formatc1702/kTrainer/Media/Photos/Assembly/2017-06-02 23.36.27.jpg

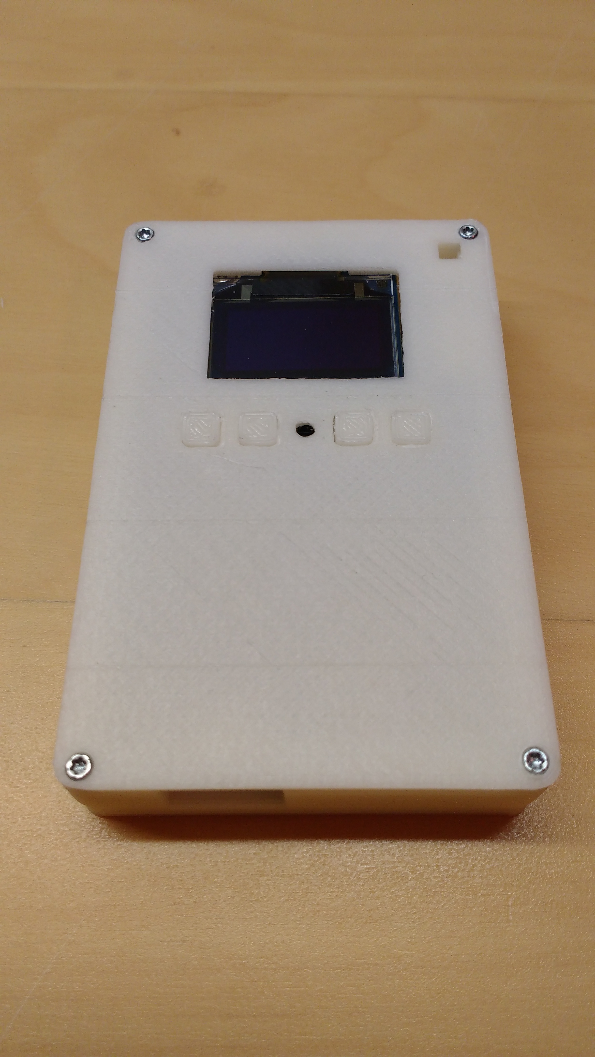
Media/Photos/Assembly/2017-06-02 23.36.27.jpg
