formatc1702/kTrainer/EAGLE/ktrainer.dxf

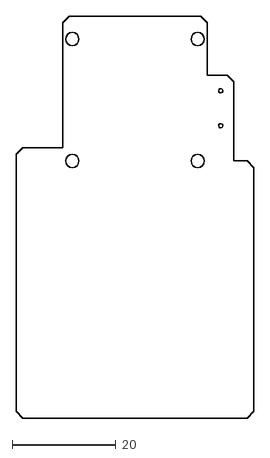
[picture p3: CAD file, 2017-05-26]
EAGLE/ktrainer.dxf
45.7 x 77.5
