formatc1702/kTrainer/Mechanical/parts-3d-print/STL/case-bottom.stl

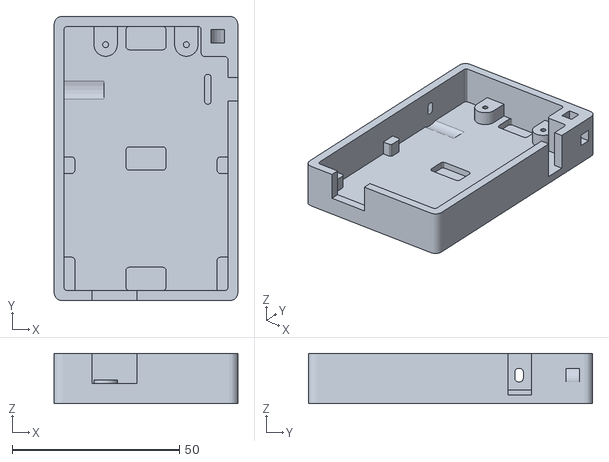
[picture p4: CAD file, 2017-06-03]
Mechanical/parts-3d-print/STL/case-bottom.stl
55.0 x 85.0 x 15.0
