formatc1702/kTrainer/Mechanical/Test/buttontest.stl

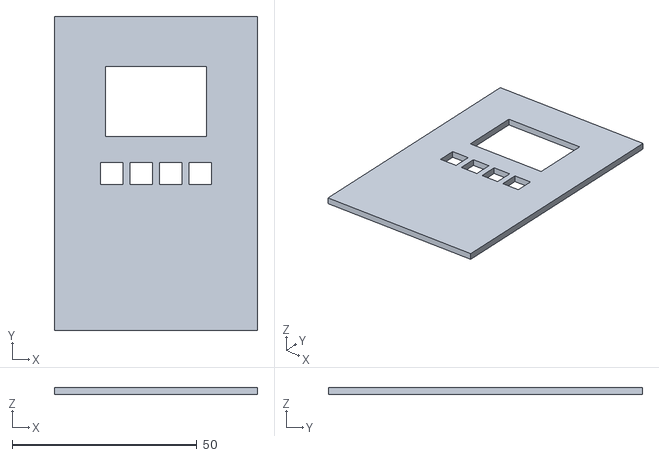
[picture p5: CAD file, 2017-03-10]
Mechanical/Test/buttontest.stl
55.0 x 85.0 x 2.00
