formatc1702/kTrainer/Mechanical/parts-3d-print/STL/button-double.stl

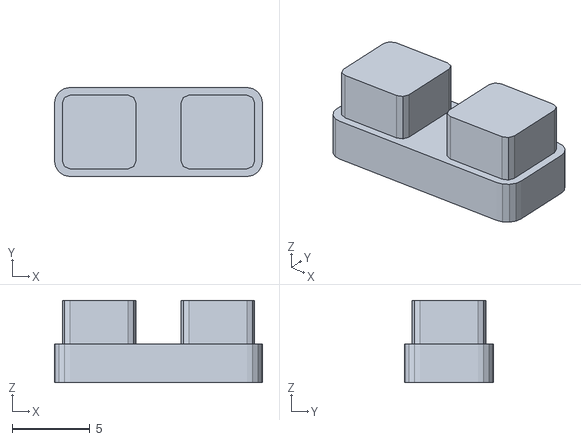
[picture p6: CAD file, 2017-06-03]
Mechanical/parts-3d-print/STL/button-double.stl
13.4 x 5.74 x 5.30
