formatc1702/kTrainer/Mechanical/parts-3d-print/STL/case-top.stl

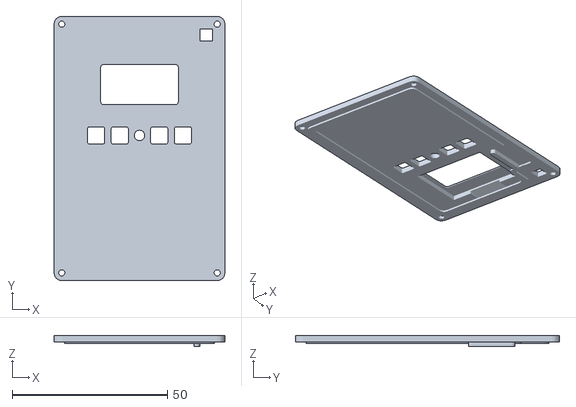
[picture p7: CAD file, 2017-06-02]
Mechanical/parts-3d-print/STL/case-top.stl
55.0 x 85.0 x 3.50
