formatc1702/kTrainer/Mechanical/parts-3d-print/STL/oled-spacer.stl

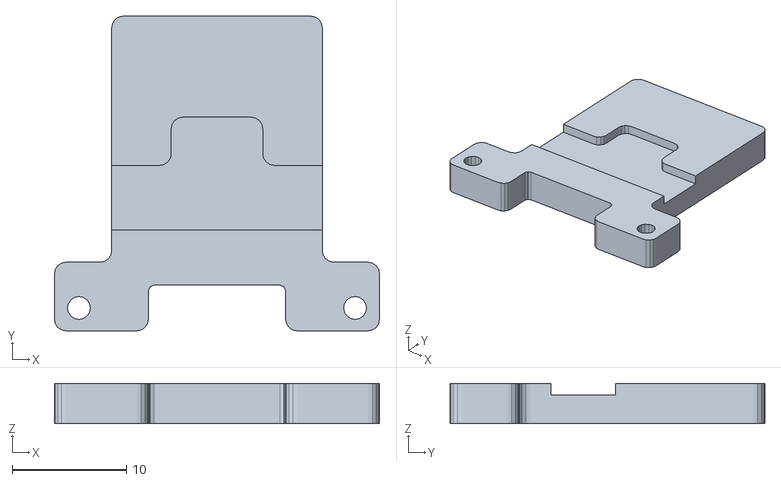
[picture p8: CAD file, 2017-06-02]
Mechanical/parts-3d-print/STL/oled-spacer.stl
28.4 x 27.5 x 3.50
