formatc1702/kTrainer/Mechanical/parts-3d-print/STL/slider.stl

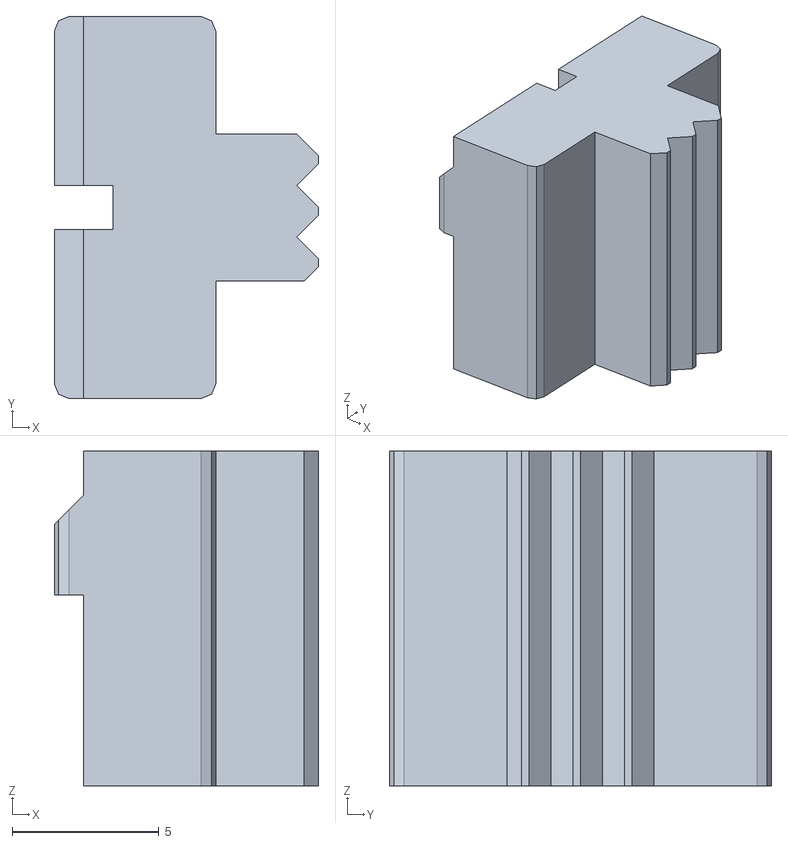
[picture p9: CAD file, 2017-06-02]
Mechanical/parts-3d-print/STL/slider.stl
9.00 x 13.0 x 11.4
