formatc1702/kTrainer/Media/Photos/Assembly/2017-06-02 22.41.26.jpg

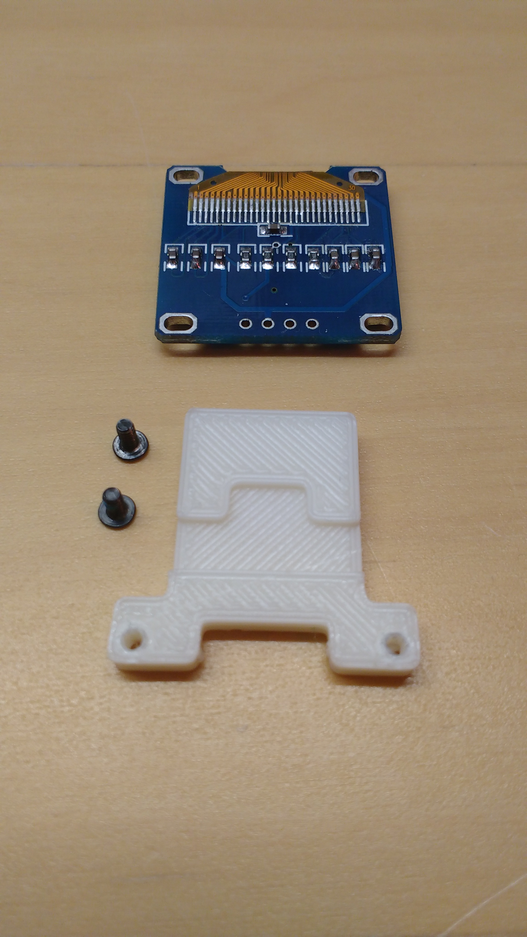
Media/Photos/Assembly/2017-06-02 22.41.26.jpg
