formatc1702/kTrainer/Media/Photos/Assembly/2017-06-02 22.42.33.jpg

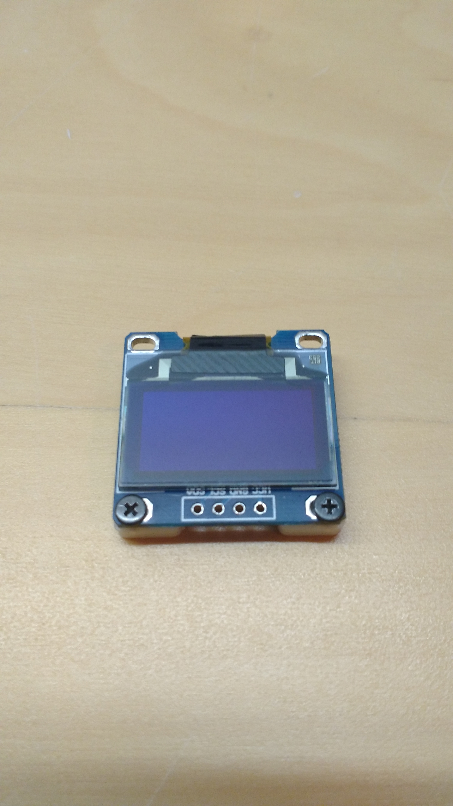
Media/Photos/Assembly/2017-06-02 22.42.33.jpg
