formatc1702/kTrainer/Media/Photos/Assembly/2017-06-02 23.09.38.jpg

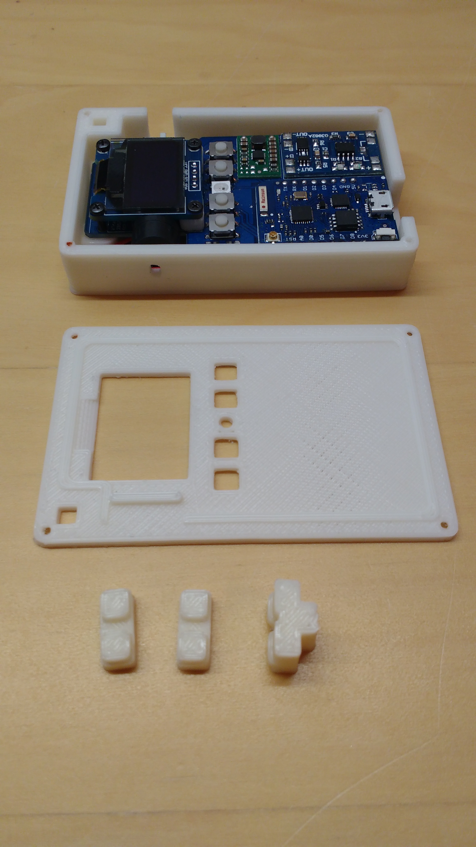
Media/Photos/Assembly/2017-06-02 23.09.38.jpg
