formatc1702/kTrainer/Media/Photos/Assembly/2017-06-02 23.37.00.jpg

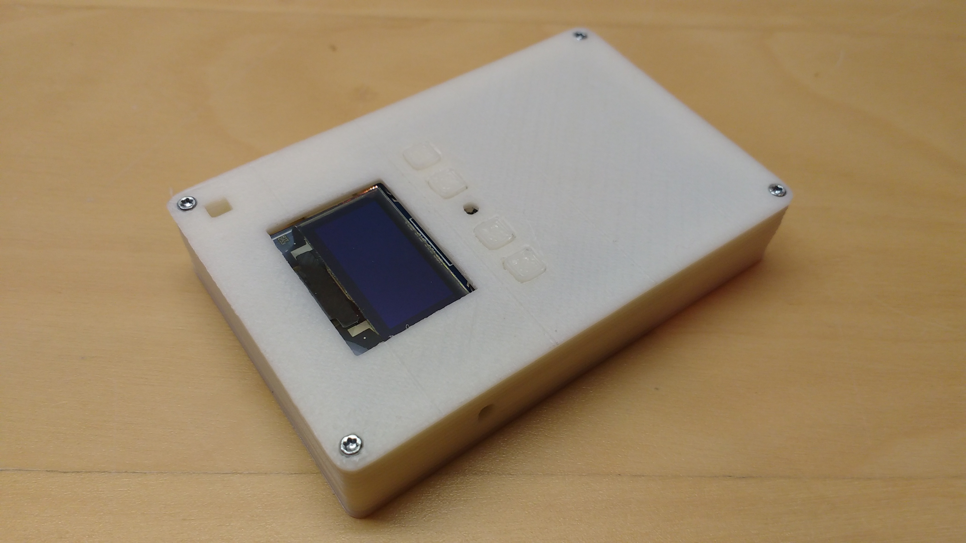
Media/Photos/Assembly/2017-06-02 23.37.00.jpg
