formatc1702/kTrainer/Media/Photos/Assembly/2017-06-02 23.48.02.jpg

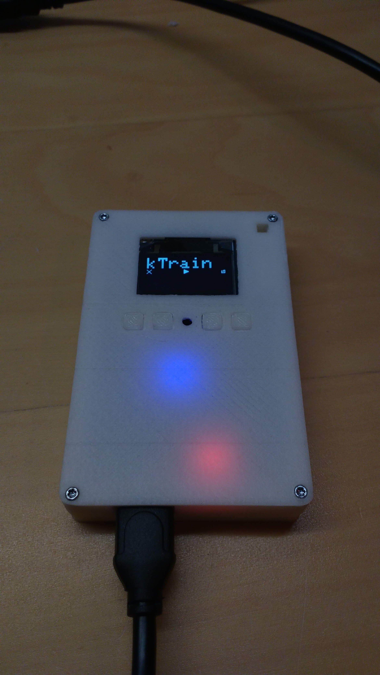
Media/Photos/Assembly/2017-06-02 23.48.02.jpg
