formatc1702/kTrainer/Media/Photos/Assembly/2017-06-03 13.04.07.jpg

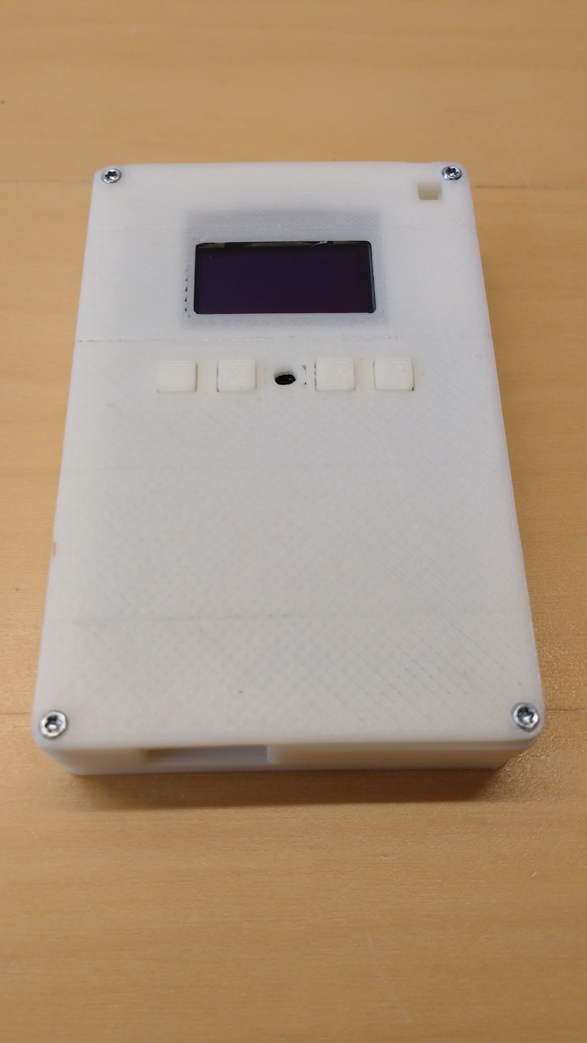
Media/Photos/Assembly/2017-06-03 13.04.07.jpg
