formatc1702/kTrainer/EAGLE/ktrainer.brd

## EAGLE design EAGLE/ktrainer.brd (2018-06-24)

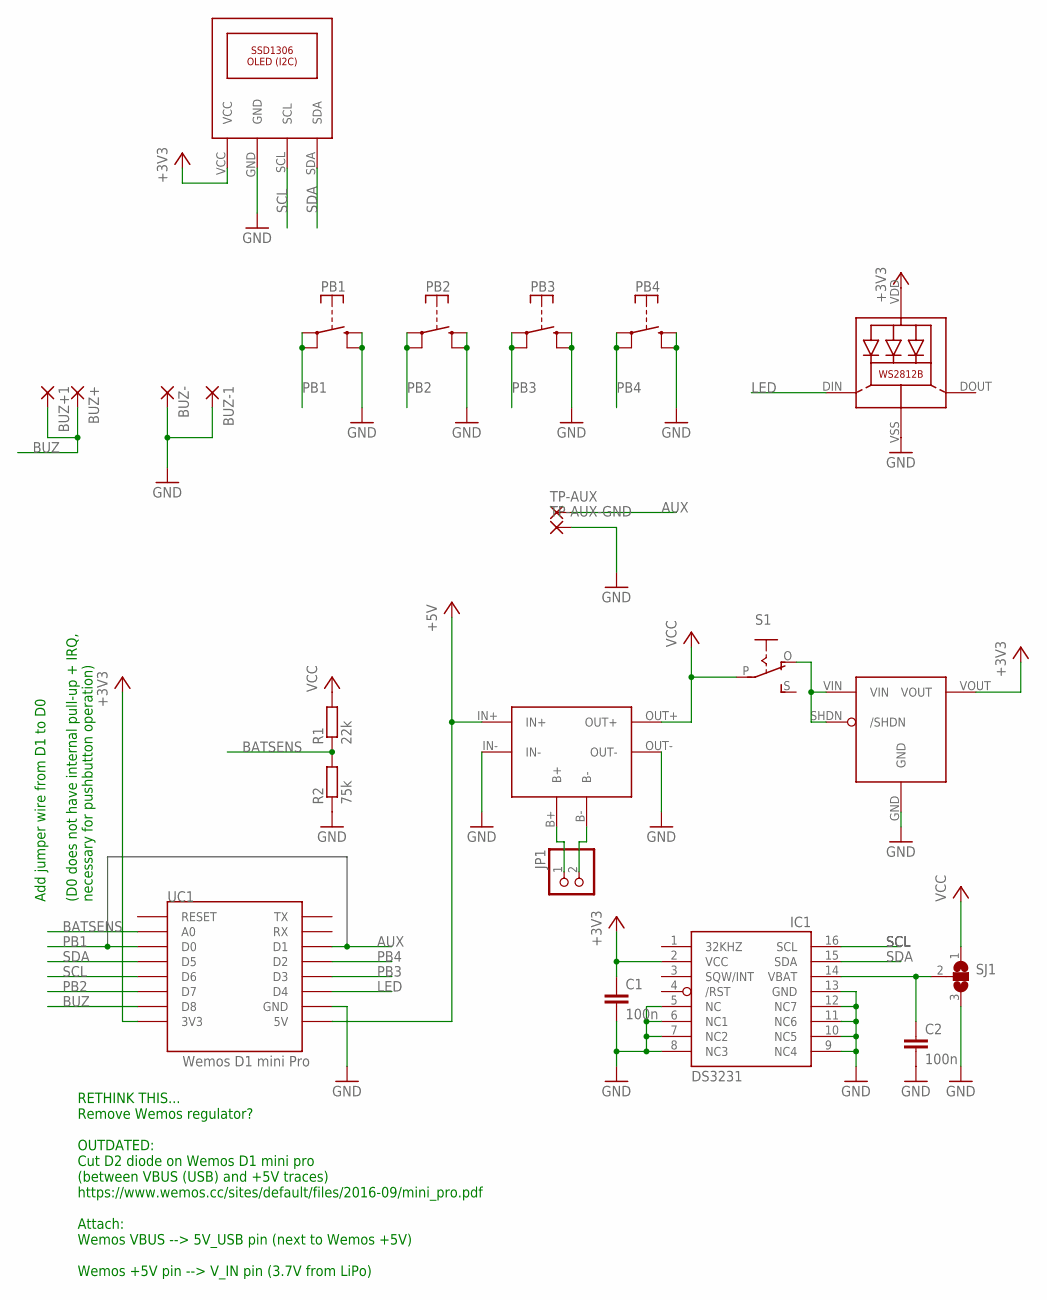
[picture p28: schematic ktrainer.sch]

Parts:
BUZ+, BUZ+1: SMD2; SMD1,27-2,54
BUZ-, BUZ-1: SMD2; SMD1,27-2,54
C1, C2: 100n; C0805
IC1: DS3231/SO; SO16W
JP1: PINHD-1X2; 1X02
LED1: WS2812B
PB1, PB2, PB3, PB4: SWITCH-SKRA; SWITCH-SKRA-PKG
R1: 22k; R0805
R2: 75k; R0805
S1: SWITCH-MSK12D04-SLIDER-SMD; SWITCH-MSK12D04-SLIDER-SMD-PKG
SJ1: SJ2W; SJ_2
TP-AUX: SMD2; SMD1,27-2,54
TP-AUX-GND: SMD2; SMD1,27-2,54
U$1: TP4056-LIPO-CHG-PCBTP4056-PCB-SMD; TP4056-PCB-SMD
U$2: SSD1306-OLED-128X64-I2CSSD1306-OLED-128X64-SMD; SSD1306-OLED-128X64-SMD
U$3: POLOLU-S7V8F3-3V3-STEP-UP-DOWNPOLOLU-S7V8F3-PAD; POLOLU-S7V8F3-SMD
UC1: Wemos D1 mini Pro; WEMOS-D1-MINI-SMD

Connections:
+3V3: C1.1, IC1.2 (VCC), LED1.VDD, U$2.VCC, U$3.VOUT, UC1.3V3
+5V: U$1.IN+, UC1.5V
AUX: TP-AUX.1, UC1.D1
B-: JP1.2, U$1.B-
BATSENS: R1.1, R2.2, UC1.A0
BUZ: BUZ+.1, BUZ+1.1, UC1.D8
GND: BUZ-.1, BUZ-1.1, C1.2, C2.2, IC1.5 (NC), IC1.6 (NC1), IC1.7 (NC2), IC1.8 (NC3), IC1.9 (NC4), IC1.10 (NC5), IC1.11 (NC6), IC1.12 (NC7), IC1.13 (GND), LED1.VSS (GND), PB1.P$1, PB1.P$2, PB2.P$1, PB2.P$2, PB3.P$1, PB3.P$2, PB4.P$1, PB4.P$2, R2.1, SJ1.3, TP-AUX-GND.1, U$1.IN-, U$1.OUT-, U$2.GND, U$3.GND, UC1.GND
LED: LED1.DIN (DI), UC1.D4
unnamed: S1.O, U$3.SHDN (/SHDN), U$3.VIN
PB1: PB1.P$3 (S), PB1.P$4 (S), UC1.D0
PB2: PB2.P$3 (S), PB2.P$4 (S), UC1.D7
PB3: PB3.P$3 (S), PB3.P$4 (S), UC1.D3
PB4: PB4.P$3 (S), PB4.P$4 (S), UC1.D2
SCL: IC1.16 (SCL), U$2.SCL, UC1.D6
SDA: IC1.15 (SDA), U$2.SDA, UC1.D5
VBAT: C2.1, IC1.14 (VBAT), SJ1.2
VCC: JP1.1, R1.2, S1.P, SJ1.1, U$1.B+, U$1.OUT+

Notes on the sheet:
RETHINK THIS... Remove Wemos regulator? OUTDATED: Cut D2 diode on Wemos D1 mini pro (between VBUS (USB) and +5V traces) https://www.wemos.cc/sites/default/files/2016-09/mini_pro.pdf Attach: Wemos VBUS --> 5V_USB pin (next to Wemos +5V) Wemos +5V pin --> V_IN pin (3.7V from LiPo)
Add jumper wire from D1 to D0 (D0 does not have internal pull-up + IRQ, necessary for pushbutton operation)

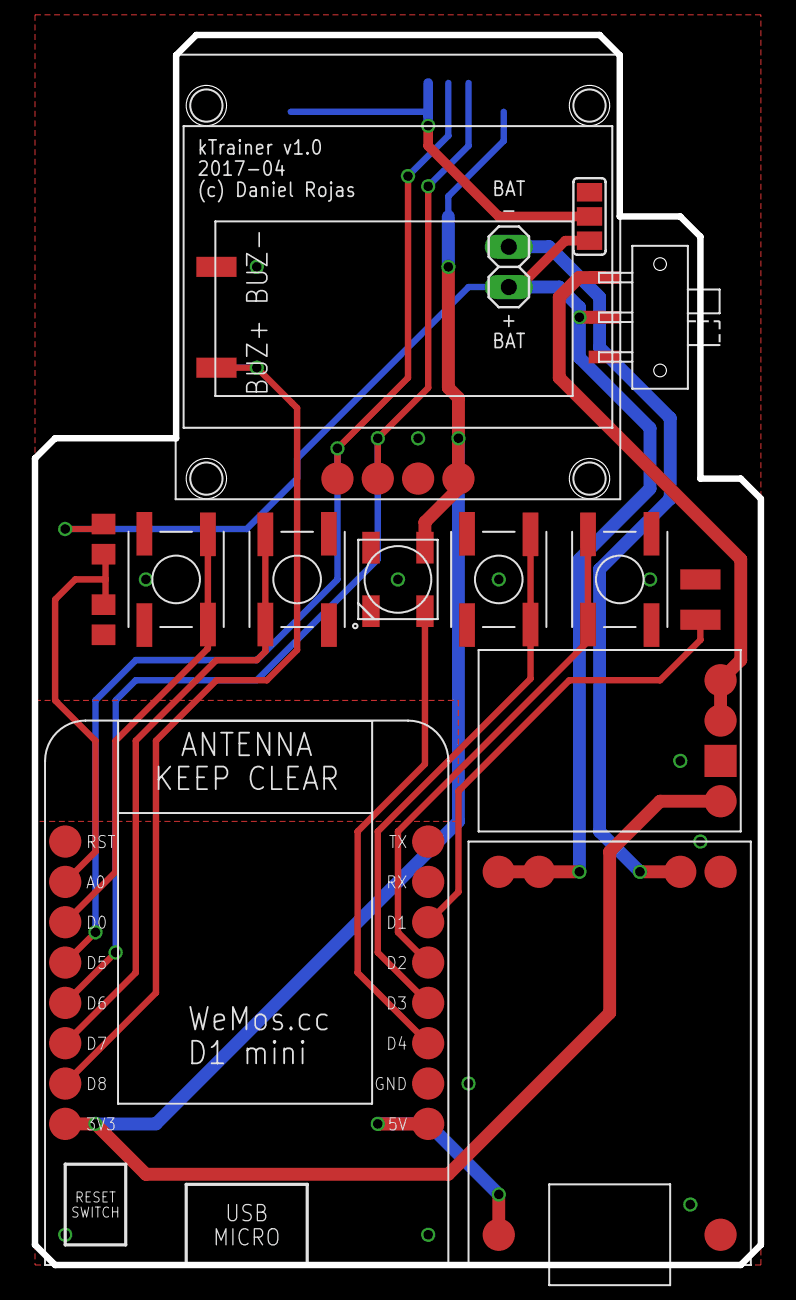
[picture p29: board ktrainer.brd from above]

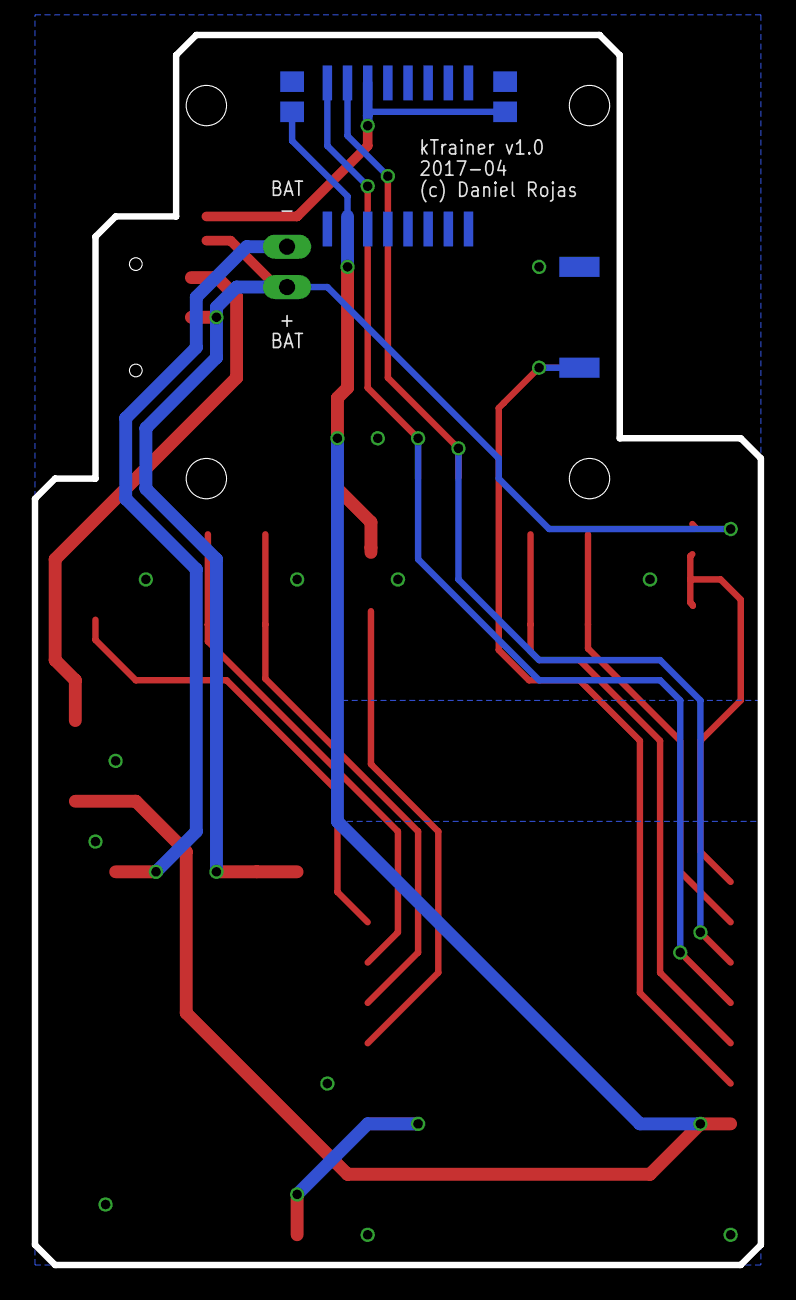
[picture p30: board ktrainer.brd from below]

Board: 2 copper layers, 45.7 x 77.5 mm, 23 parts (5 on the bottom side), 17 nets.
