formatc1702/kTrainer/Firmware/bitmapfont.py

# MicroPython basic bitmap font renderer.
# Author: Tony DiCola
# License: MIT License (https://opensource.org/licenses/MIT)
import ustruct


class BitmapFont:

    def __init__(self, width, height, pixel, fill_rect, font_name='font5x8.bin'):
        # Specify the drawing area width and height, and the pixel function to
        # call when drawing pixels (should take an x and y param at least).
        # Optionally specify font_name to override the font file to use (default
        # is font5x8.bin).  The font format is a binary file with the following
        # format:
        # - 1 unsigned byte: font character width in pixels
        # - 1 unsigned byte: font character height in pixels
        # - x bytes: font data, in ASCII order covering all 255 characters.
        #            Each character should have a byte for each pixel column of
        #            data (i.e. a 5x8 font has 5 bytes per character).
        self._width = width
        self._height = height
        self._pixel = pixel
        self._fill_rect = fill_rect
        self._font_name = font_name

    def init(self):
        # Open the font file and grab the character width and height values.
        # Note that only fonts up to 8 pixels tall are currently supported.
        self._font = open(self._font_name, 'rb')
        self._font_width, self._font_height = ustruct.unpack('BB', self._font.read(2))

    def deinit(self):
        # Close the font file as cleanup.
        self._font.close()

    def __enter__(self):
        self.init()
        return self

    def __exit__(self, exception_type, exception_value, traceback):
        self.deinit()

    def draw_char(self, ch, x, y, size, *args, **kwargs):
        # Don't draw the character if it will be clipped off the visible area.
        if x < -self._font_width or x >= self._width or \
           y < -self._font_height or y >= self._height:
            return
        # Go through each column of the character.
        for char_x in range(self._font_width):
            # Grab the byte for the current column of font data.
            self._font.seek(2 + (ord(ch) * self._font_width) + char_x)
            line = ustruct.unpack('B', self._font.read(1))[0]
            # Go through each row in the column byte.
            if size == 1:
                for char_y in range(self._font_height):
                    # Draw a pixel for each bit that's flipped on.
                    if (line >> char_y) & 0x1:
                        self._pixel(x + char_x, y + char_y, *args, **kwargs)
            else:
                for char_y in range(self._font_height):
                    # Draw a pixel for each bit that's flipped on.
                    if (line >> char_y) & 0x1:
                        self._fill_rect(x + (char_x * size), y + (char_y * size), size, size, *args, **kwargs)
                        # for rr in range(0,size):
                            # for cc in range(0,size):
                                # self._pixel(x + (char_x) * size + cc,y +  (char_y) * size + rr, *args, **kwargs)

    def text(self, text, x, y, size=1, *args, **kwargs):
        # Draw the specified text at the specified location.
        for i in range(len(text)):
            self.draw_char(text[i], x + (i * (self._font_width + 1) * size), y, size,
                           *args, **kwargs)

    def width(self, text):
        # Return the pixel width of the specified text message.
        return len(text) * (self._font_width + 1)
