formatc1702/kTrainer/(commit log)

2017-02-16 First EAGLE tests
    [ktrainer.brd, ktrainer.sch]
2017-02-26 Working state machine with 3 button control!
    [myparams.txt]
2017-02-26 Save works upon startup, not after -> memory problem? implement load/save_training as part of kTraining class!
    [ktraining.py, main.py]
2017-02-27 Implement various changes
    De-clutter state machine
    implement load/save training into kTrain class
    add review mode
    fix bugs
    [boot.py, ktraining.py, main.py, statemachine.py, test1.py]
2017-02-27 Remove blocking sleep() calls, implement skip/reset during countdown
    [main.py]
2017-03-10 Edit s_before… getting MemoryError!
2017-03-10 First thoughts on the physical layout of buttons & screen
    [buttontest.stl, ktrainer.brd, ktrainer.sch]
2017-03-28 Work on schematic/PCB (not finished)
    [ktrainer.brd, ktrainer.sch]
2017-04-14 More work on schematic/PCB (not finished)
    [ktrainer.brd, ktrainer.sch]
2017-04-14 Make PCB fully SMD (only vias, no through-hole pads)
    [ktrainer.brd, ktrainer.sch]
2017-04-14 Add mechanical CAD (not finished)
2017-04-17 More PCB work
    [ktrainer.brd]
2017-04-17 Correct bitmapfont behavior with text size > 1
    [bitmapfont.py]
2017-04-23 Finish work on PCB, create gerber files and order on Seeed Studio
    [ktrainer.GBL, ktrainer.GBO, ktrainer.GBP, ktrainer.GBS, ktrainer.GTL, ktrainer.GTO, ktrainer.GTP, ktrainer.GTS]
2017-05-26 Update code to match PCB pins
2017-05-26 Disable RGB LED at boot
    (because it's on the same pin as the on-board LED)
2017-05-26 Add SolveSpace 3D CAD model
    [buttontest.stl, ktrainer.dxf]
2017-05-26 Further 3D modeling (case top, USB, etc.)
2017-05-26 Add standoffs to support PCB
2017-05-29 Add spacer between OLED and PCB
    [oled-spacer.stl]
2017-05-29 Edit case bottom
2017-06-02 Add rim to case top
2017-06-02 Test print bottom + slider
    [case-bottom-no-floor.stl, slider.stl]
2017-06-02 Add geometry for buzzer (hole + pocket), print case bottom
    [case-bottom-no-floor.stl, case-bottom.stl]
2017-06-02 Model M1.6 Torx screws to hold top and bottom together
2017-06-02 Adjust geometry and print slider
    [slider.stl]
2017-06-02 Adjust geometry and print case top
    [case-top.stl]
2017-06-02 Button test print
    [button-double.stl]
2017-06-02 Adjust geometry and print top case (2nd try)
    [case-top.stl]
2017-06-02 Adjust geometry and print OLED spacer
    [oled-spacer.stl]
2017-06-02 Add photos of assembly process
2017-06-02 Adjust geometry and reprint buttons
    [button-double.stl]
2017-06-02 Adjust geometry and reprint case top (3rd try)
    [case-top.stl]
2017-06-03 Adjust geometry and reprint buttons (2nd and 3rd tries)
    [button-double.stl]
2017-06-03 Add simple firmware, similar to kTimer (LED only)
2017-06-03 Add 1mm of additional space for LiPo below PCB
    [case-bottom.stl]
2017-06-03 Implement non-blocking LED blinker
2017-06-03 Update training plan and parameters
    [myparams.txt]
2017-06-03 Annotate schematic: jumper wire from D1 to D0
    [ktrainer.brd, ktrainer.sch]
2017-06-03 Adapt firmware to show four icons for four buttons
2017-06-03 Include buzzer (disabled for now)
    [main.py]
2017-06-09 Convert LED hole to pocket (0.2mm wall thickness), since it's bright enough -> BREAKS main assembly!
2017-07-08 Update training plan
    [myparams.txt]
2018-06-24 Set resistor values for ADC voltage divider
    [ktrainer.brd, ktrainer.sch]
